stafforj/Automated-Relay-Switch/(commit log)

2023-03-16 edited code for Arduino
2023-03-16 bom additions
2023-03-16 bom update
2023-03-16 updated BOM
